ilovemicroplastics/OpenScoutV1-1/Documentation/CAD_Files/README.md

# Index of files

## DXF Files. These files are used for Laser Cutting

They can be found in the DXF folder in this directory.

## STEP Files. These files can be modified in generic 3D CAD software

## Instruction Manual. Hard copy instructions for building the robot chassis
