ilovemicroplastics/OpenScoutV1-1/Hardware/robot_with_lazy_susan_bearing/din_rail.md

# Din rail

## Build time = 15 minutes

### Bill of materials:

| Material | Quantity | Reference | UK link |
| ---|---:|:---:|:---:|
| Din rail with terminal blocks | 1 | DT | [Link](https://amz.run/5TFF) |
| 10A circuit breaker | 1 | E2 | [Link](https://amz.run/5TFI) |
| M4 8mm socket screw | 2 | S4.8 | - |
| M4 T-slot nuts | 2 | T4 | - |
| M5 Washers | 2 | N3 | - |

## Introduction

The din rail (DT) consists of a holed metal with some terminal blocks (red & white) attached on it. You can attach as many as you wish, and its purpose is provide some convience while wiring the battery.

## Step-by-step instructions

1. Attach the terminal blocks and the circuit breaker (E2) on the (DT). They 'click' if fitted properly, and they freely move along the rail.

<p float="center">
  Attaching the terminal blokcs on the din rail.
  The din rail assembled
</p>

2. Fit in-place 2 (T4) nuts on the extrusion that will accommodate the din rail and screw the rail on them using (N3) washers. Make sure that is properly fitted by giving it a shake.

<p float="center">
  Attaching the terminal blokcs on the din rail.
  The din rail assembled
</p>

## What's next?
Follow the [attaching motors and wheels](./motors_and_wheels.md) tutorial to complete the chassis of the robot.

#### Page last reviewed by: B.K. on 19/07/25

Notes - It technically will work, but needs to be modified to fit the circuit diagram. That is to say some of these din rails aren't needed anymore, only 1 or 2 are in use. Also because of their spotty availablity it might be worth assessing alternatives.
