ilovemicroplastics/OpenScoutV1-1/Demonstrations/README.md

# Demonstrations

This folder contains a range of demonstration videos of the OpenScout to showcase its versatility, Lazy Susan mechanism, speed and agility as well as general movement capabilities. Additionally there is a video showing the simulated environment.

## 1 - OpenScout v2 Driving

https://github.com/user-attachments/assets/4c83e099-2132-454d-ae23-d050e3298f1a

## 2 - OpenScout v2 Simulation

https://github.com/user-attachments/assets/db36529f-7577-4ad0-a52f-730f6c3506c2

#### Page last reviewed by: B.K. on 19/07/25

Notes - It's a bit barren but I can't do much about this right now. If significant changes are made do make sure to update the videos here. If you don't know how to make these links, its very bizzare, you put a video into a new issue and you copy the link that gets created. That link won't die it will keep showing the video even if you don't submit the issue.
